adnet-solutions/adnet-access/esphome/README.md

# Firmware für den Leser (AtomS3 Lite)

| Datei | Inhalt |
|---|---|
| `haustuer-zutritt.yaml` | ESPHome-Konfiguration: Wiegand (Karte + Tasten), PIN-Sammler, verschlüsselte API, Offline-Modus |
| `adnet_access.h` | PIN-HMAC und Prüfung der Offline-Liste |
| `haustuer-zutritt-rfid2-test.yaml` | **Testaufbau** mit M5Stack Unit RFID2 am Grove-Port: nur Karten, keine PIN, sonst identisch |
| `secrets.example.yaml` | Vorlage für die Secrets |

Geprüft mit ESPHome 2026.7 und 2026.9 (`esphome config`). Hinweis: `rgb_order` ab 2027.3 durch `channel_colors` ersetzen.

1. Die Dateien `haustuer-zutritt.yaml`, `adnet_access.h` und `adnet/gehaeusetemperatur.yaml` (im Unterordner `adnet/`, sonst zeigt ESPHome sie als eigenes Gerät) in den ESPHome-Ordner von HA kopieren (`/config/esphome/`).
2. Werte aus `secrets.example.yaml` in die ESPHome-`secrets.yaml` übernehmen. Schlüssel erzeugen:
   `openssl rand -base64 32` (API) und `openssl rand -hex 24` (PIN). Beide auch in die Add-on-Optionen eintragen.
3. Erster Flash per USB-C (dabei die 5-V-Ader vom Wandler abklemmen), danach per WLAN.
4. Das Gerät **nicht** zwingend in die ESPHome-Integration von HA aufnehmen; das Add-on verbindet sich selbst. Wird es aufgenommen, sind die Ereignis-Sensoren dort standardmäßig ausgeblendet.

**Bedienung an der Tastatur:** Karte vorhalten. PIN: Ziffern, dann `#`. `*` löscht. Bei *Karte + PIN* erst Karte, dann innerhalb von 15 s PIN + `#`.

**Tastatur auf Wiegand 34 stellen** (bei der UHPPOTE: schwarze und graue Ader verbinden, siehe Hardware-Anleitung). Bei 26 Bit überträgt sie nur einen Teil der Karten-ID.

**D0/D1 vertauscht?** Dann kommen falsche Karten-IDs und keine Tasten an. In der YAML einfach `GPIO1` und `GPIO2` tauschen.

## Testaufbau ohne Tastatur (M5Stack Unit RFID2)

Solange die Wiegand-Tastatur fehlt, kann der Atom mit der **Unit RFID2** getestet werden: RFID2 per Grove-Kabel an den Atom, Atom per USB-C an Rechner oder Netzteil. In den Add-on-Optionen `reader_type: rfid2` setzen. Statt `haustuer-zutritt.yaml` die Datei `haustuer-zutritt-rfid2-test.yaml` (plus `adnet_access.h` und `adnet/gehaeusetemperatur.yaml` im Unterordner `adnet/`) ins ESPHome-Add-on kopieren und flashen. Gerätename, Schlüssel und Ablauf sind gleich, das Add-on merkt keinen Unterschied – nur PIN gibt es nicht.

- Karten anlernen, Zeitprofile, Logbuch, Snapshot, Push, Shelly, Offline-Modus: alles testbar.
- Die Karten-ID kommt hier als Hex (`74-10-37-94`), an der Wiegand-Tastatur später als Dezimalzahl. Das Add-on rechnet beides ineinander um – **angelernte Karten bleiben gültig**. Beim Umstieg nur in den Add-on-Optionen `reader_type` von `rfid2` auf `wiegand34` stellen (für die Offline-Liste).
- Umstieg: `haustuer-zutritt.yaml` öffnen, *Install → Wirelessly*. Gleicher Name, also Update per WLAN.

## Optional: Gehäusetemperatur (DS18B20)

`adnet/gehaeusetemperatur.yaml` (im Unterordner `adnet/`, sonst zeigt ESPHome sie als eigenes Gerät) wird über `packages:` eingebunden. DS18B20: rot → 3,3 V, schwarz → GND, gelb → **G7**, 4,7 kΩ zwischen gelb und 3,3 V. Ohne Sensor läuft alles normal, die Entität „Gehäusetemperatur“ ist dann nicht verfügbar. Ganz abschalten: die Zeile unter `packages:` auskommentieren und neu flashen. Zusätzlich meldet der Atom immer seine **Chiptemperatur** (Diagnose, liegt 10–20 K über der Gehäuseluft).

## Offline-Modus mit Shelly-Passwort

Ist am Shelly ein Passwort gesetzt, meldet sich der Atom im Offline-Modus per HTTP-Digest (SHA-256) als `admin` an. Dafür `adnet_shelly_password` auch in die **ESPHome**-Secrets eintragen (ohne Passwort: `""`). Die Berechnung ist gegen das Testbeispiel aus RFC 7616 geprüft (`adnet::digest_header`).
