adnet-solutions/adnet-access/hardware/inneneinheit/verkabelungsplan_inneneinheit_A4.pdf

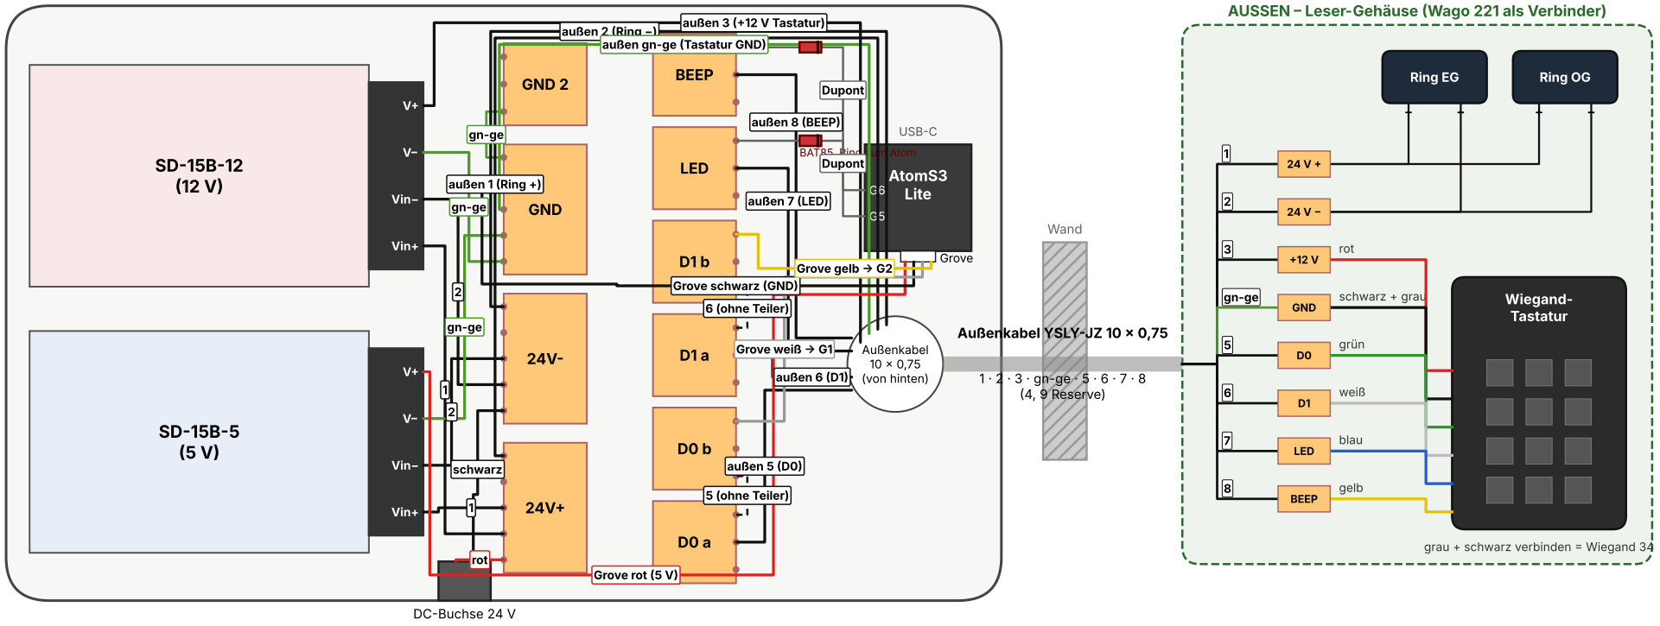
[picture p4: figure]
Vin−; Vin+; GND; GND 2; LED; BEEP; AtomS3 Lite; USB-C; Grove; Außenkabel 10 × 0,75 (von hinten); DC-Buchse 24 V; BAT85, Ring zum Atom; Wand; Außenkabel YSLY-JZ 10 × 0,75; 1 · 2 · 3 · gn-ge · 5 · 6 · 7 · 8 (4, 9 Reserve); Wiegand-; Tastatur; rot; schwarz + grau; grün; weiß; blau; gelb; grau + schwarz verbinden = Wiegand 34; Ring EG; Ring OG; schwarz; außen 1 (Ring +); außen 2 (Ring −) außen gn-ge (Tastatur GND); außen 3 (+12 V Tastatur); außen 5 (D0); außen 6 (D1); außen 7 (LED); außen 8 (BEEP); 5 (ohne Teiler); 6 (ohne Teiler); Grove rot (5 V); Grove schwarz (GND); Grove weiß → G1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

AUSSEN – Leser-Gehäuse (Wago 221 als Verbinder)

# Verkabelungsplan Inneneinheit – AD.NET Access

Blick von vorn, Deckel ab · verkleinert, Lage der Bauteile maßstäblich · Kabel laufen über die Wagos (darüber ca. 25 mm frei)

Adern YSLY-JZ 10 × 0,75 mm² – außen und innen dieselben Nummern

1 24 V + : außen Ring + · innen Wago 24V+ → Eingang Vin+ beider Wandler

2 24 V − : außen Ring − · innen Wago 24V− → Eingang Vin− beider Wandler

3 +12 V : SD-15B-12 Klemme +V → Tastatur rot

gn-ge | GND : Tastatur schwarz · innen Ausgang −V beider Wandler → GND, Brücke GND ↔ GND 2
5 / 6 | D0 / D1 : Tastatur grün / weiß → Wago D0 a / D1 a · innen Brücke a ↔ b nur ohne Spannungsteiler
7 / 8 | LED / BEEP : Tastatur blau / gelb → Wago LED / BEEP
4, 9 | Reserve (4 innen ggf. als 5-V-Verlängerung)

Hinweise

Außenkabel: Belegung siehe README (1/2 = Ring 24 V).

24 V− (Ring-Kreis) und GND sind getrennt – nicht verbinden.

Klemmenreihenfolge der Wandler laut Aufdruck am Gerät

(Vin+/Vin− Eingang, +V/−V Ausgang).

Vor dem Anschluss von Tastatur/Atom: 12 V / 5 V messen.

LED/BEEP erst nach dem Messen anschließen.
