adnet-solutions/adnet-access/hardware/inneneinheit/belegung_inneneinheit_A4.pdf

## Belegungsschild Inneneinheit – zum Ausschneiden und Laminieren

1. Mit 100 % drucken (nicht „an Seite anpassen“). Kontrolle: der Strich unten muss genau 50 mm lang sein.
2. Papier an der durchgezogenen Linie ausschneiden (66 × 106 mm).
3. Laminieren, dabei ringsum ca. 4 mm Folie überstehen lassen.
4. Folie auf das Endmaß 74 × 114 mm zuschneiden (gestrichelte Linie als Schablone, Ecken leicht abrunden).
5. Innen in den Deckel kleben: über Atom / rechter Wago-Spalte (von innen gesehen links neben den Fühlerklemmen). Zwei Exemplare – eins als Reserve.

## Belegung Inneneinheit

Adern YSLY-JZ 10 × 0,75 · außen = innen
Ader | Funktion
gn-ge | GND (nicht 24 V −!)
1 24 V + / Ring +
2 24 V − / Ring −
3 12 V + Tastatur

### 4 Reserve 5 D0 6 D1 7 LED 8 BEEP 9 Reserve

Atom | Signal
G1 | D0 (Grove)
G2 | D1 (Grove)
5V + GND Grove
G5 | LED (über BAT85)
G6 | BEEP (über BAT85)
G7 | Temperatur DS18B20

## Belegung Inneneinheit

Adern YSLY-JZ 10 × 0,75 · außen = innen
Ader | Funktion
gn-ge | GND (nicht 24 V −!)
1 24 V + / Ring +
2 24 V − / Ring −
3 12 V + Tastatur

### 4 Reserve 5 D0 6 D1 7 LED 8 BEEP 9 Reserve

Atom | Signal
G1 | D0 (Grove)
G2 | D1 (Grove)
5V + GND Grove
G5 | LED (über BAT85)
G6 | BEEP (über BAT85)
G7 | Temperatur DS18B20

Kontrollstrich: genau 50 mm
