adnet-solutions/adnet-access/archiv/README.md

# Archiv

[`rfid2-sockel/`](rfid2-sockel/): erster Entwurf mit einem M5Stack-RFID2-Leser in einem Sockel unter der Ring-Doppelplatte und NFC-Aufkleber unter dem Dach. Ersetzt durch die Wiegand-Tastatur mit Karte und PIN (siehe [`../hardware/`](../hardware/)). Nur noch zum Nachschlagen; Pfade und Verweise darin stammen aus dem alten Repository und stimmen nicht mehr.
