adnet-solutions/adnet-access/hardware/inneneinheit/stl/innen_niederhalter_5v.stl

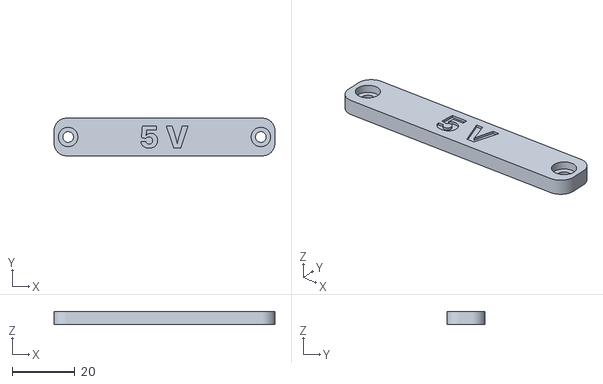
[picture p8: CAD file, 2026-10-23]
hardware/inneneinheit/stl/innen_niederhalter_5v.stl
70.2 x 12.0 x 4.00
