adnet-solutions/adnet-access/hardware/inneneinheit/stl/innen_niederhalter_5v_schrift.stl

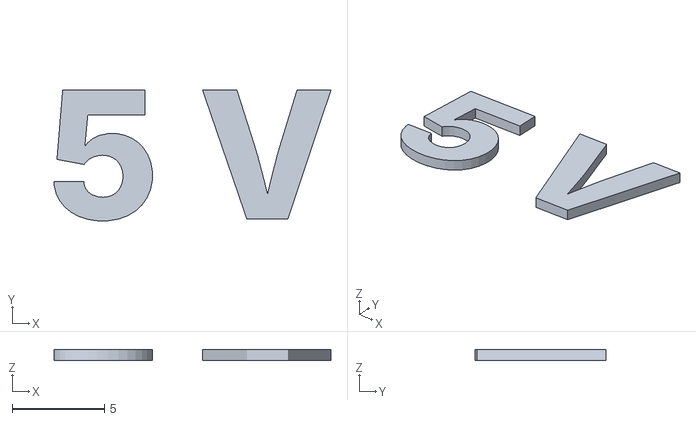
[picture p9: CAD file, 2026-10-23]
hardware/inneneinheit/stl/innen_niederhalter_5v_schrift.stl
15.0 x 7.09 x 0.6
