adnet-solutions/adnet-access/hardware/inneneinheit/stl/innen_niederhalter_12v_schrift.stl

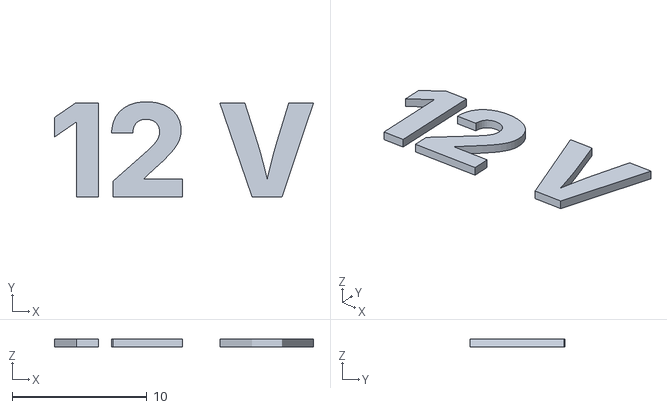
[picture p10: CAD file, 2026-10-23]
hardware/inneneinheit/stl/innen_niederhalter_12v_schrift.stl
19.2 x 7.09 x 0.6
