adnet-solutions/adnet-access/hardware/inneneinheit/stl/innen_unterteil.stl

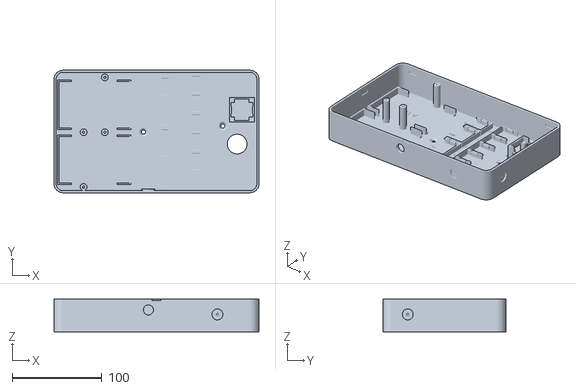
[picture p11: CAD file, 2026-10-22]
hardware/inneneinheit/stl/innen_unterteil.stl
228.8 x 136.8 x 36.4
