adnet-solutions/adnet-access/hardware/inneneinheit/stl/innen_unterteil_schrift.stl

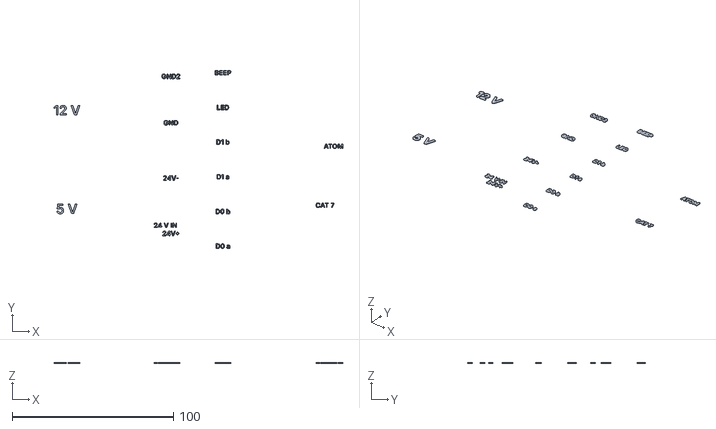
[picture p12: CAD file, 2026-10-22]
hardware/inneneinheit/stl/innen_unterteil_schrift.stl
179.2 x 110.5 x 0.8
