adnet-solutions/adnet-access/hardware/inneneinheit/stl/test_wago_aufnahme.stl

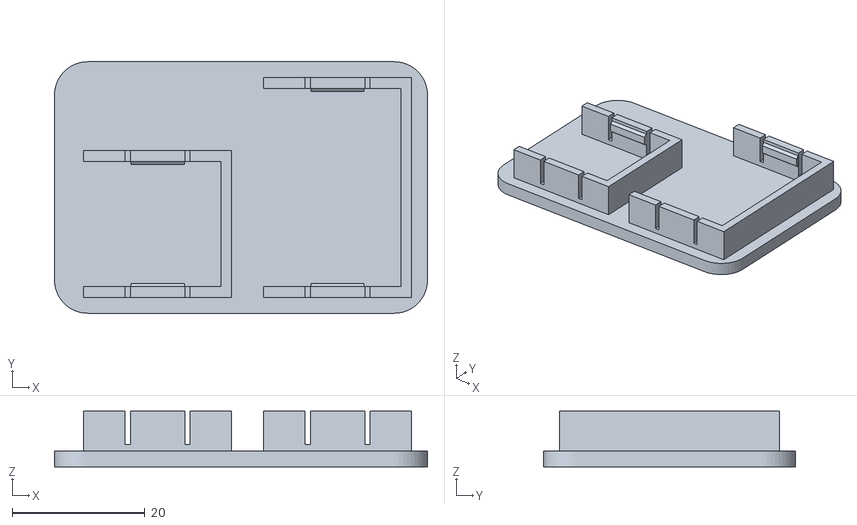
[picture p13: CAD file, 2026-10-21]
hardware/inneneinheit/stl/test_wago_aufnahme.stl
56.2 x 37.9 x 8.40
