adnet-solutions/adnet-access/hardware/inneneinheit/stl/test_wago_varianten.stl

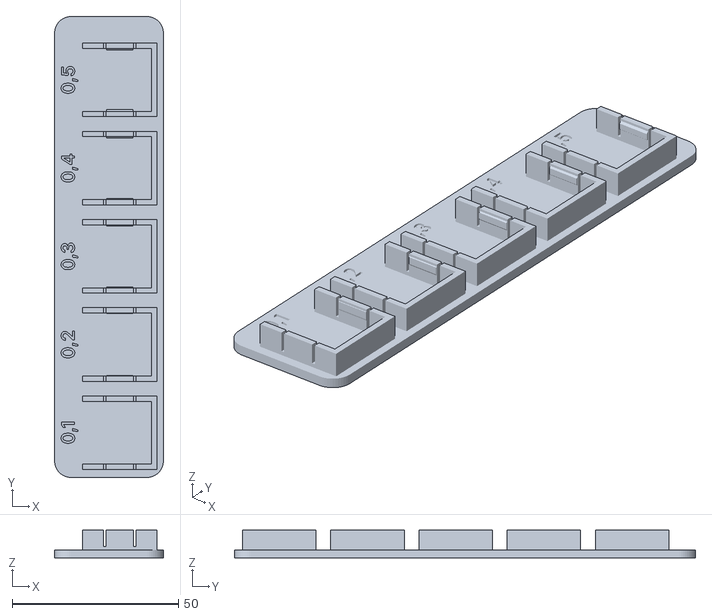
[picture p14: CAD file, 2026-10-21]
hardware/inneneinheit/stl/test_wago_varianten.stl
32.7 x 138.5 x 8.40
