adnet-solutions/adnet-access/hardware/inneneinheit/stl/innen_deckel_einlage_logo_grau.stl

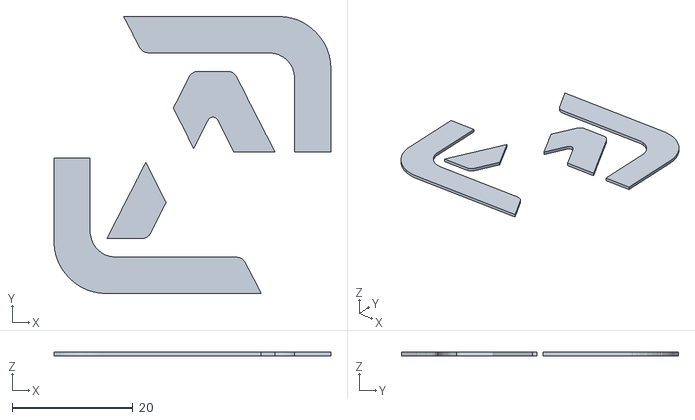
[picture p15: CAD file, 2026-10-21]
hardware/inneneinheit/stl/innen_deckel_einlage_logo_grau.stl
45.9 x 45.9 x 0.6
