adnet-solutions/adnet-access/hardware/inneneinheit/stl/innen_deckel_einlage_schrift.stl

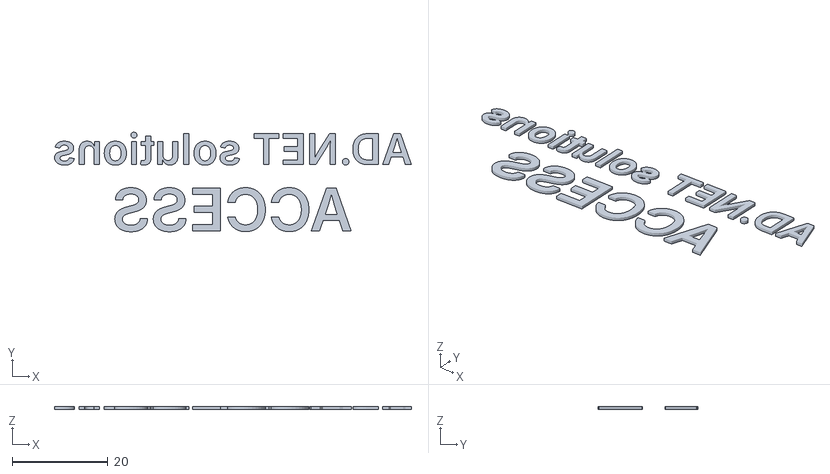
[picture p16: CAD file, 2026-10-21]
hardware/inneneinheit/stl/innen_deckel_einlage_schrift.stl
74.6 x 20.8 x 0.6
