adnet-solutions/adnet-access/hardware/inneneinheit/stl/innen_deckel_einlage_logo_orange.stl

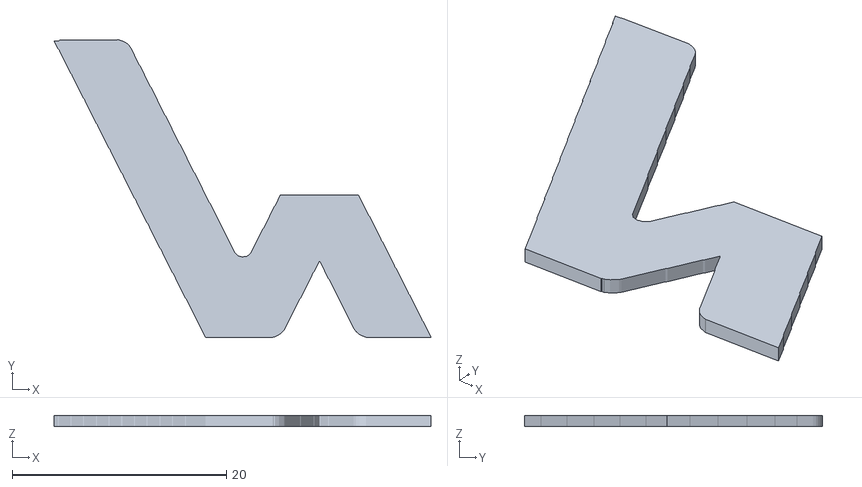
[picture p17: CAD file, 2026-10-21]
hardware/inneneinheit/stl/innen_deckel_einlage_logo_orange.stl
35.2 x 27.8 x 1.00
