adnet-solutions/adnet-access/hardware/inneneinheit/stl/innen_deckel.stl

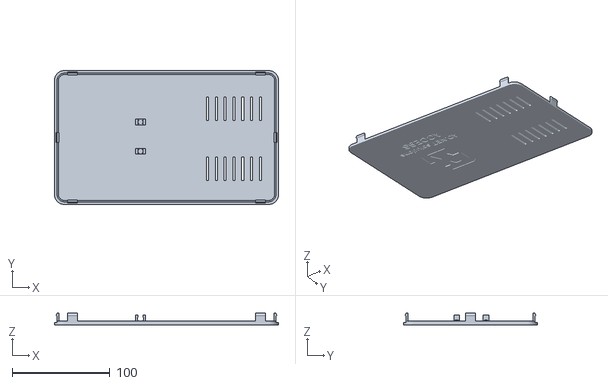
[picture p18: CAD file, 2026-10-20]
hardware/inneneinheit/stl/innen_deckel.stl
228.8 x 136.8 x 12.4
