adnet-solutions/adnet-access/archiv/rfid2-sockel/stl/sockel_zutritt.stl

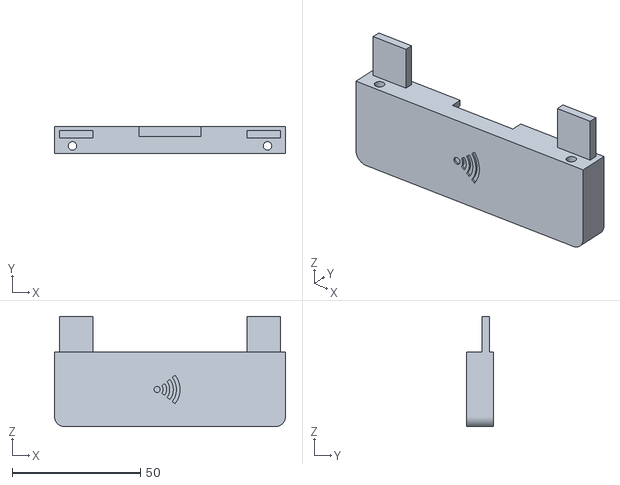
[picture p19: CAD file, 2026-10-18, an earlier design]
archiv/rfid2-sockel/stl/sockel_zutritt.stl
90.0 x 10.6 x 43.0
