adnet-solutions/adnet-access/archiv/rfid2-sockel/stl/sockel_zutritt_symbol.stl

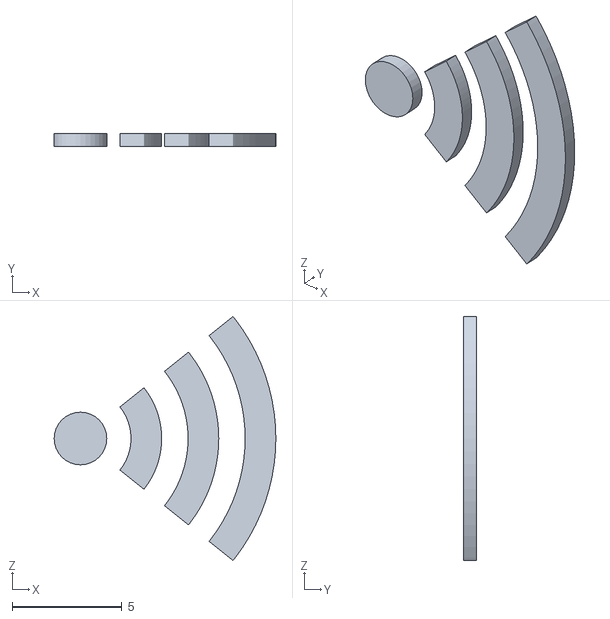
[picture p20: CAD file, 2026-10-18, an earlier design]
archiv/rfid2-sockel/stl/sockel_zutritt_symbol.stl
10.1 x 0.6 x 11.1
