adnet-solutions/adnet-access/(list of files, cad)

Other CAD files:
hardware/inneneinheit/stl/innen_niederhalter_12v.stl
