adnet-solutions/adnet-access/(commit log)

2026-10-18 AD.NET Access: Zutrittskontrolle als Home-Assistant-Add-on
    - Add-on (Ingress-UI): Personen mit Gueltigkeit, Modi Karte/PIN/Karte+PIN/Karte-oder-PIN,
    mehrere Karten, Anlernen, Sperre bis, Handy-Webhook, Zeitprofile, Feiertage, Kalender,
    Urlaubs-/Tastatursperre, Lockout, Logbuch mit UniFi-Snapshot und Protect-Link, CSV,
    Aufraeumen, waehlbarer Speicherort (intern/NAS) mit Ausweich-Ordner, MQTT-Entitaeten
    - ESPHome-Firmware fuer AtomS3 Lite an der Wiegand-Tastatur: Noise-verschluesselte API,
    PIN nur als HMAC, Offline-Liste und Offline-Protokoll
    - Hardware: Inneneinheit V2 (STL + Generator), Teileliste, Cat-7-Belegung, Spannungsteiler
    - Archiv: alter RFID2-Sockel-Entwurf (aus ring-doorbel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
    [innen_deckel.stl, innen_niederhalter.stl, innen_unterteil.stl]
2026-10-18 Archiv: Sockel-STLs, Skripte und Generator-Patch aus dem Ring-Repo vollstaendig uebernommen
    Claude-Session: https://claude.ai/code/session_011JPLrZmyzWFds59TCAZ7zb
    [sockel_zutritt.stl, sockel_zutritt_symbol.stl]
2026-10-18 Shelly- und Leser-Adresse optional (0.1.1)
    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
2026-10-18 Shelly-Pruefung auf der Einstellungsseite (0.1.3)
    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
2026-10-18 Eigener MQTT-Broker einstellbar, optional TLS (0.1.6)
    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
    [config.yaml]
2026-10-18 MQTT-Pruefung auf der Einstellungsseite (0.1.8)
    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
2026-10-18 Personenliste: Zutritt heute und morgen (0.1.11)
    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
2026-10-19 Hardware: Aderfarben und LED/Summer laut Anleitung HBK-D02K
    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
2026-10-20 Inneneinheit V2.1 (Entwurf): 2. GND-Wago, Wagos fuer LED/BEEP, Atom auf Podest fuer Dupont an G5/G6
    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
    [innen_unterteil.stl]
2026-10-20 Hardware-README: V2.1 Teileliste und Verdrahtung LED/BEEP, GND 2
    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
2026-10-20 Inneneinheit V2.1: Wago-Masse laut Datenblatt (221-413 18,8 mm, 221-415 29,9 mm), Spalte 1 = 3x415 + 1x413
    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
    [innen_unterteil.stl]
2026-10-20 Inneneinheit: Deckel zum Aufschnappen (6 Rasthaken, Hebelkerbe), Schraubdome entfallen
    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
    [innen_deckel.stl, innen_unterteil.stl]
2026-10-20 Inneneinheit: Eckanschlaege an der Klemmenseite der Wandler, Bodenbeschriftung 3 mm hoch und 0,8 mm tief
    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
    [innen_unterteil.stl]
2026-10-20 Inneneinheit: Bodenbeschriftung als eigenes Teil fuer zweifarbigen Druck
    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
    [innen_unterteil_2farbig.3mf, innen_unterteil_schrift.stl]
2026-10-20 Inneneinheit: Wago-Aufnahmen quer enger (0,2 mm Spiel, 0,9-mm-Rastnasen), Passungstest-STL
    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
    [innen_unterteil.stl, innen_unterteil_schrift.stl, test_wago_aufnahme.stl]
2026-10-20 Inneneinheit: Platz fuer Klemmleiste und Adern vor den Wagos, Wago-Breite nachgemessen, Plan aus Layoutdaten
    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
    [innen_deckel.stl, innen_unterteil.stl, innen_unterteil_schrift.stl, test_wago_aufnahme.stl]
2026-10-20 Inneneinheit: Wago-Breite 18,6 mm (nachgemessen), 221-415 hochgerechnet 29,6 mm
    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
    [innen_unterteil.stl, innen_unterteil_schrift.stl, test_wago_aufnahme.stl]
2026-10-20 Inneneinheit: Wandlerlaenge mit Klemme 90,5 mm (nachgemessen)
    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
2026-10-20 Inneneinheit: Wandler ganz links (17,5 mm Aderraum), Spalte 2 oeffnet nach rechts zu Cat 7/Atom, Delock und Bohrung versetzt
    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
    [innen_deckel.stl, innen_unterteil.stl, innen_unterteil_schrift.stl]
2026-10-20 3MF zweifarbig auf aktuellen Stand
    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
    [innen_unterteil_2farbig.3mf]
2026-10-20 Inneneinheit: Atom ganz nach rechts oben
    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
    [innen_unterteil.stl, innen_unterteil_2farbig.3mf, innen_unterteil_schrift.stl]
2026-10-20 Inneneinheit: DC-Einbaubuchse (Loch 11,2 mm) statt Delock 65524 und Kabelkerbe
    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
    [innen_deckel.stl, innen_unterteil.stl, innen_unterteil_2farbig.3mf, innen_unterteil_schrift.stl]
2026-10-20 Inneneinheit: Logo + AD.NET ACCESS als Farbeinlage im Deckel, Lueftungsschlitze ueber den Wandlern, Kabelfarben
    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
    [innen_deckel.stl, innen_deckel_3farbig.3mf, innen_deckel_logo_grau.stl, innen_deckel_logo_orange.stl]
2026-10-20 Deckel: Logo + AD.NET solutions / ACCESS einfarbig eingraviert, mittig untereinander
    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
    [innen_deckel.stl, innen_deckel_3farbig.3mf, innen_deckel_logo_grau.stl, innen_deckel_logo_orange.stl]
2026-10-20 Deckel-Logo: Stege zwischen grau und orange, orange Flaechen 1 mm tief
    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
    [innen_deckel.stl]
2026-10-20 DC-Buchse: Loch 11,4 mm fuer M11-Gewinde
    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
    [innen_unterteil.stl]
2026-10-20 DC-Buchse: Loch 8,3 mm fuer DC-099 (M8)
    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
    [innen_unterteil.stl]
2026-10-20 DC-Buchse in den Adergang links neben 24V+ verlegt (10-cm-Litzen reichen)
    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
    [innen_unterteil.stl, innen_unterteil_schrift.stl]
2026-10-20 DC-Buchse hoeher (22 mm ueber Boden): Mutter liegt ueber Wagos und Klemmleiste
    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
    [innen_unterteil.stl]
2026-10-20 README: DC-099 in der Teileliste
    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
2026-10-20 Niederhalter: Senkung fuer Linsenkopfschrauben 2,9
    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
    [innen_niederhalter.stl]
2026-10-20 ESPHome: Chiptemperatur des Atom als Diagnose-Sensor
    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
2026-10-20 Inneneinheit: 3 vorgepraegte Bohrstellen fuer Kabelverschraubung M12
    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
    [innen_unterteil.stl]
2026-10-20 Deckel: Klemmen fuer DS18B20-Temperaturfuehler innen
    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
    [innen_deckel.stl]
2026-10-21 Wago-Passungstest: Grundplatte mit runden Ecken
    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
    [test_wago_aufnahme.stl]
2026-10-21 Deckel: Einlagen (Logo grau/orange, Schrift) als eigene STLs
    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
    [innen_deckel_einlage_logo_grau.stl, innen_deckel_einlage_logo_orange.stl, innen_deckel_einlage_schrift.stl]
2026-10-21 Inneneinheit: Atom 18 mm tiefer, ca. 29 mm Platz fuer USB-C-Stecker
    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
    [innen_unterteil.stl, innen_unterteil_schrift.stl]
2026-10-21 Bodenbeschriftung CAT 7 unter die Bohrung (war von Kabelbinderbruecke verdeckt)
    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
    [innen_unterteil.stl, innen_unterteil_schrift.stl]
2026-10-21 ESPHome: Temperatur-Package in Unterordner adnet/ (Dashboard zeigt es sonst als Geraet)
    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
2026-10-21 Add-on 0.1.14: Logbuch und Uebersicht aktualisieren sich live
    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
2026-10-21 Add-on 0.1.16: Snapshot in Full HD, Kamerabild als Ersatz in der Benachrichtigung
    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
2026-10-21 Add-on 0.1.18: Offline-Oeffnungen mit echter Uhrzeit in der Benachrichtigung
    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
2026-10-21 Wago-Aufnahmen: flache Klemmnasen mit Einfuehrschraege auf Federzungen (statt 0,9-mm-Nasen)
    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
    [innen_unterteil.stl, test_wago_aufnahme.stl]
2026-10-21 Variantentest Wago-Klemmnasen 0,1-0,5 mm (beschriftet)
    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
    [test_wago_varianten.stl]
2026-10-21 DC-Buchse: Loch 11,2 mm (Gewinde gemessen 10,73 mm)
    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
    [innen_unterteil.stl]
2026-10-21 Add-on 0.1.20: Filter in Uebersicht, Weg-Filter + Suche, aktive Navigation, Loeschen-Layout
    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
2026-10-21 Add-on 0.1.21: Logbuch-Loeschen in die Einstellungen verschoben
    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
2026-10-21 Belegung mit nummerierten Adern (YSLY-JZ) in README, Belegungsschild zum Einkleben in den Deckel
    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
    [belegung_schild.stl, belegung_schild_schrift.stl]
2026-10-21 Belegungsschild: ExtraBold 3,5 mm (Strich 0,8 mm) fuer 0,4er-Duese
    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
    [belegung_schild.stl, belegung_schild_schrift.stl]
2026-10-21 Wago-Klemmnasen 0,5 mm (Variantentest); Spalte 2 mit geteilten Waenden nur aussen
    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
    [innen_unterteil.stl, test_wago_aufnahme.stl, test_wago_varianten.stl]
2026-10-21 Belegungsschild: Schrift auf der Bettseite (gespiegelt) fuer saubere Kanten
    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
    [belegung_schild.stl, belegung_schild_schrift.stl]
2026-10-22 Wago-Spalte 2: jede Aufnahme eigene 1-mm-Federwaende mit 0,6 mm Luft und beidseitigen Nasen
    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
    [innen_unterteil.stl, innen_unterteil_schrift.stl]
2026-10-23 Niederhalter beschriftet: eigene STLs fuer 12 V und 5 V (+ Schrift-Einlage)
    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
    [innen_niederhalter.stl, innen_niederhalter_12v.stl, innen_niederhalter_12v_schrift.stl, innen_niederhalter_5v.stl, innen_niederhalter_5v_schrift.stl]
2026-10-23 Niederhalter 12 mm breit, Schrift 7 mm
    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
    [innen_niederhalter_12v.stl, innen_niederhalter_12v_schrift.stl, innen_niederhalter_5v.stl, innen_niederhalter_5v_schrift.stl]
2026-10-23 3MF Unterteil zweifarbig auf aktuellen Stand
    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
    [innen_unterteil_2farbig.3mf]
2026-10-23 Belegungsschild als A4-PDF zum Laminieren (statt Druckteil); Druckeinstellungen pro Teil in der Doku
    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
    [belegung_schild.stl, belegung_schild_schrift.stl]
2026-10-23 Irrefuehrende 3MF (zwei getrennte Objekte) entfernt, Hinweis zum Import als ein Objekt
    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
    [innen_unterteil_2farbig.3mf]
2026-10-23 Verkabelungsplan 1:1 als A4-PDF; Adernbelegung an tatsaechliche Verbindungen angepasst (24V- getrennt von GND)
    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
2026-10-23 Aussenkabel: YSLY-JZ 10x0,75 statt Cat 7 (gleiche Nummern aussen/innen); Plan, Schild und README angepasst
    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
2026-10-23 Verkabelungsplan: Leser-Gehaeuse aussen mit Tastaturfarben und Ring EG/OG
    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
